Jaknil/LED_games/schematic_card.pdf

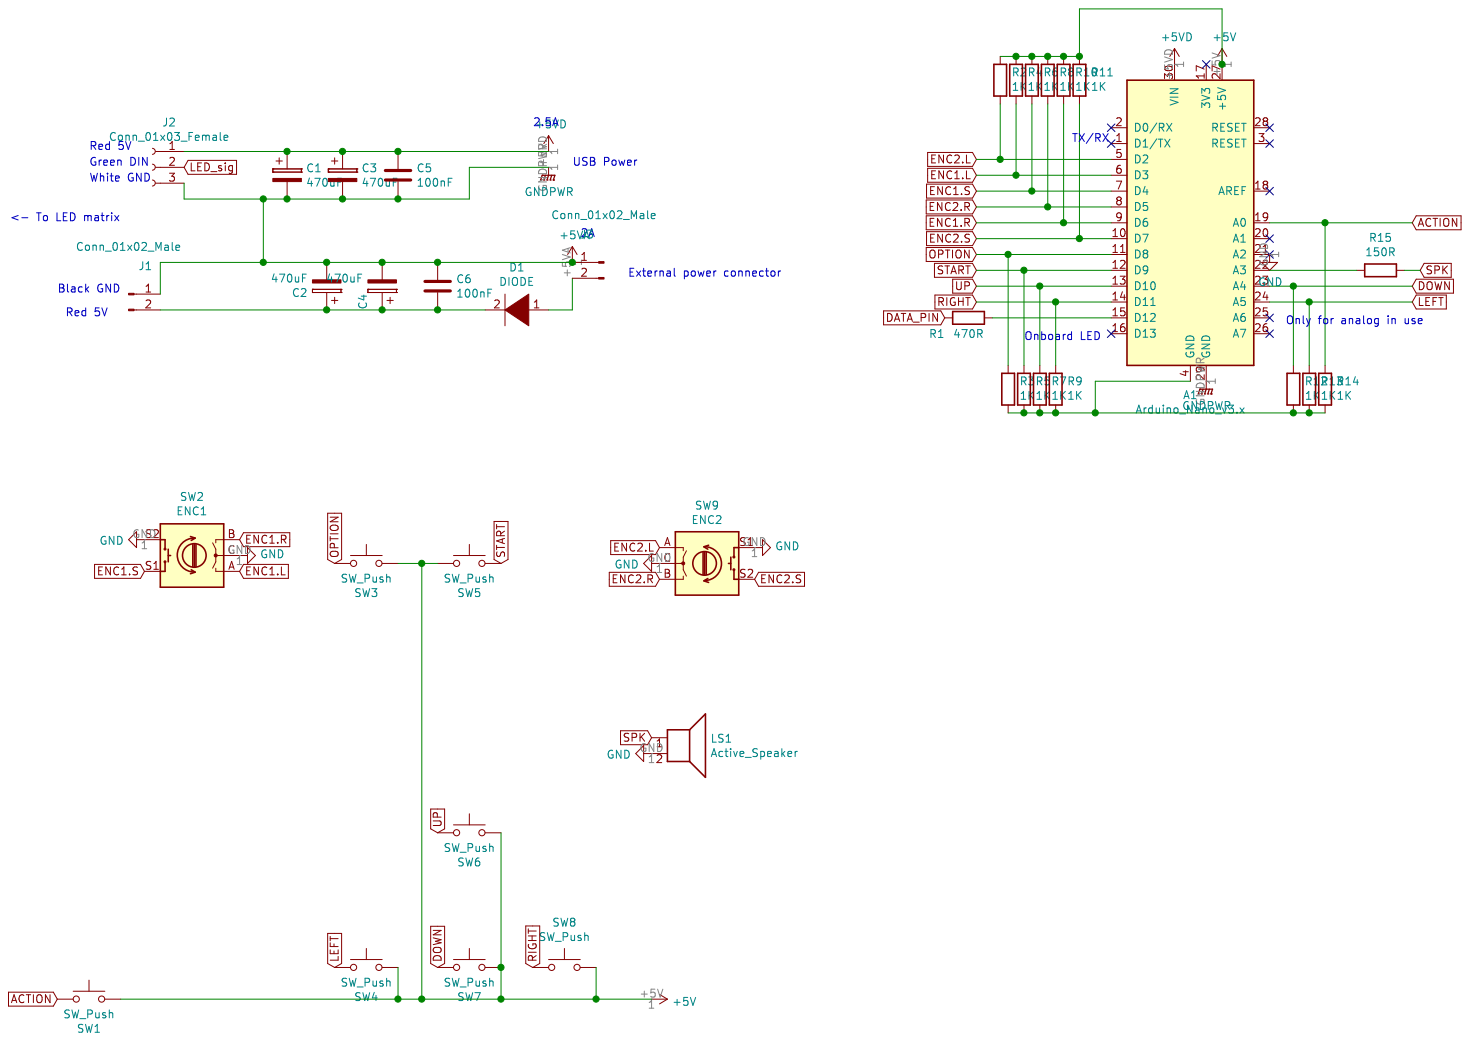
[picture p9: page 1]
