Jaknil/LED_games/Code/led_game_buttons_and_sound/led_game_buttons_and_sound.ino

/*
Test program for the buttons and sound for the LED games project

Documentation at 
https://github.com/Jaknil/LED_games/blob/master/README.md
*/

//Button variables and constants
const String buttons[] = {"OPTIONS", "START","UP","RIGHT","ACTION","DOWN","LEFT","ENC1S","ENC2S"};
const int InputPins[] = {8,9,10,11,A0,A4,A5,4,7}; // 1K Hardware pull down and positive logic for most, encoders are inverted
const int countButtons (sizeof(buttons) / sizeof(buttons[0])); //saves some MCU time
int buttonStatus[countButtons];
//OUTPUTS
#define LEDPin 13      // the number of the onboard LED OUTPUT pin 

//Speaker pin
#define SPKbuttonPin A3     // the number of the SPK speaker OUTPUT pin (active with 150Ohm series resistor)

void setup() {
    // initialize serial communication at 9600 bits per second:
  Serial.begin(9600);
  // initialize the outputs:
  pinMode(LEDPin, OUTPUT);
  pinMode(SPKbuttonPin, OUTPUT);
  
  // initialize the button pins as inputs:
  for (int i = 0; i < (countButtons); i++) {
      pinMode(InputPins[i], INPUT);
  }
}

void loop() {

ScanButtons(); //Scans all buttons

//TODO add possibillty to detect single keypresses (debounce)
//Strategy, create 2-dim array and feed it the scans, let it shift itself along.
//Scan on known interval and only change debounced result row if all are the same

//do something with the data
for (int i = 0; i < (countButtons); i++) {
if (buttonStatus[i] == HIGH){
  Serial.println(buttons[i]); //print the pressed button to serial
  delay(50);
}
}

//test LED
 if(buttonStatus[4] == HIGH){
  digitalWrite(LEDPin, HIGH);
  delay(10);
}  else {
    digitalWrite(LEDPin, LOW);
  }
//test speaker
  if(buttonStatus[0]==HIGH && buttonStatus[1]==HIGH){ //test speaker when both small buttons are pressed
  digitalWrite(SPKbuttonPin, HIGH); 
  delay(10); //short since the speaker is loud
    }else {
        // turn speaker off:
                            digitalWrite(SPKbuttonPin, LOW);
  }
}

void ScanButtons(){
//Step through and read all button pins
for (int i = 0; i < (countButtons); i++) {
buttonStatus[i] = digitalRead(InputPins[i]);
}
//invert the encoder pins since they have inverted logic
buttonStatus[7] = !buttonStatus[7];
buttonStatus[8] = !buttonStatus[8];
return;
}

  
