Jaknil/LED_games/Code/led_game_buttons/led_game_buttons.ino

/*
Test program for the buttons for the LED games project

Documentation at 
https://github.com/Jaknil/LED_games/blob/master/README.md
*/

const String buttons[] = {"OPTIONS", "START","UP","RIGHT","ACTION","DOWN","LEFT"};
const int InputPins[] = {8,9,10,11,A0,A4,A5}; // 1K Hardware pull down and positive logic

//OUTPUTS
#define LED_SIGPin 12     // the number of the LED_SIG OUTPUT pin
#define LEDPin 13      // the number of the onboard LED OUTPUT pin 
#define SPKbuttonPin A7     // the number of the SPK speaker OUTPUT pin (active with 150Ohm series resistor)

void setup() {
    // initialize serial communication at 9600 bits per second:
  Serial.begin(9600);
  // initialize the outputs:
  pinMode(LED_SIGPin, OUTPUT);
  pinMode(LEDPin, OUTPUT);
  pinMode(SPKbuttonPin, OUTPUT);
  
  // initialize the button pins as inputs:
  for (int i = 0; i < (sizeof(InputPins) / sizeof(InputPins[0])); i++) {
      pinMode(InputPins[i], INPUT);
  }
}

void loop() {

//Step through and read all button pins
for (int i = 0; i < (sizeof(buttons) / sizeof(buttons[0])); i++) {

if (digitalRead(InputPins[i]) == HIGH){
  Serial.println(buttons[i]);
  digitalWrite(LEDPin, HIGH);
  delay(100);
    }else {
        // turn LED off:
    digitalWrite(LEDPin, LOW);
  }
 
}
 
}
