Jaknil/LED_games/(commit log)

2020-07-05 Buttons are working
    [_saved_Led_game_nano.sch]
2020-07-05 improved BOM
2020-07-05 Examples of functions
    [Led_game_nano.sch, _saved_Led_game_nano.sch]
2020-07-05 Added a "turn off LED matrix" sketch
2020-07-06 Added encoder buttons
2020-07-06 separated led and speaker
2020-07-12 created function to scan buttons
2020-07-14 Added new power connectors to schematic
    [Led_game_nano.sch]
2020-07-14 Working encoder class
2020-07-28 ball class now uses timer
2023-01-04 Update README.md
    Notes on power
